smarley2/PSE/Trabalho Final/Imagens layout e circuito/Layout/Layout Top 3d.png

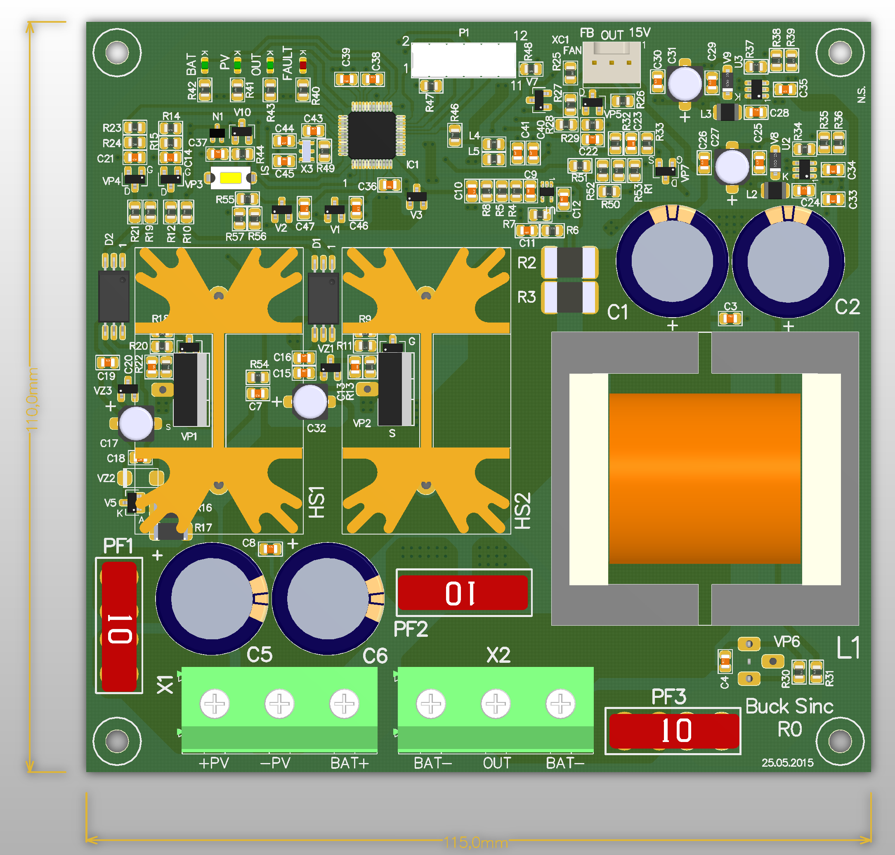
Trabalho Final/Imagens layout e circuito/Layout/Layout Top 3d.png
