smarley2/PSE/Trabalho Final/Apresentação trabalho final.pptx

Entradas: V(t); I(t);

P(t) = V(t) * I(t);

P(t) > P(t-1) ?

Sim

Não

ΔD = ΔD*(-1);

D = D + ΔD;
P(t-1) = P(t);
