smarley2/PSE/Trabalho Final/Imagens ensaio prático/20150711_115641.jpg

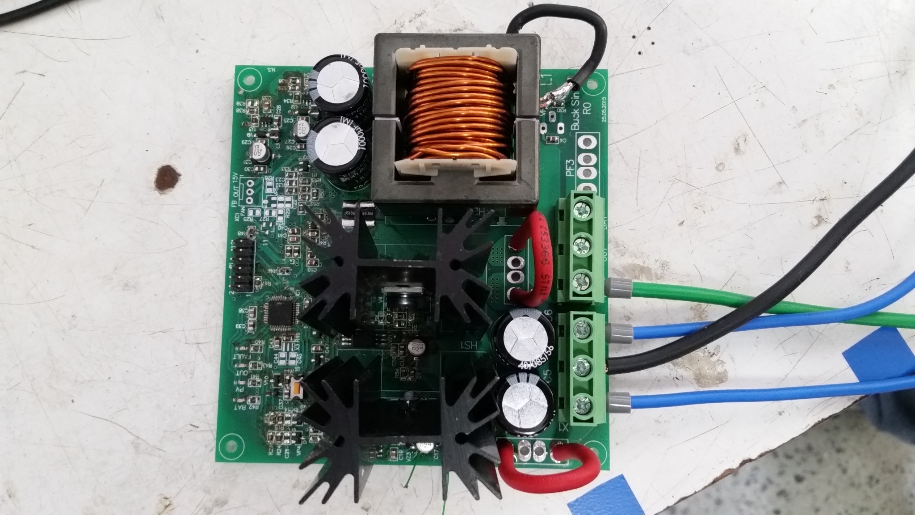
Trabalho Final/Imagens ensaio prático/20150711_115641.jpg
