smarley2/PSE/Trabalho Final/Imagens ensaio prático/20150711_115657.jpg

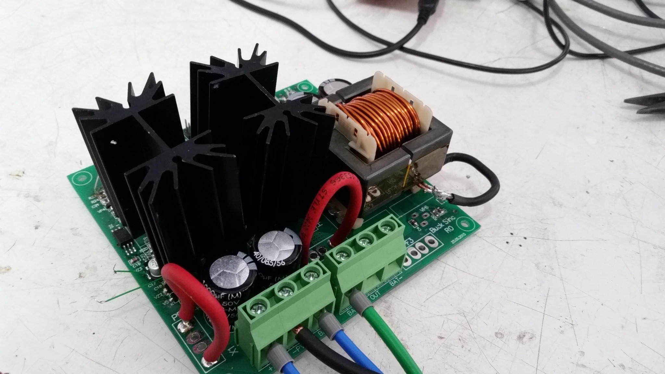
Trabalho Final/Imagens ensaio prático/20150711_115657.jpg
