smarley2/PSE/Trabalho Final/Imagens ensaio prático/20150711_115703.jpg

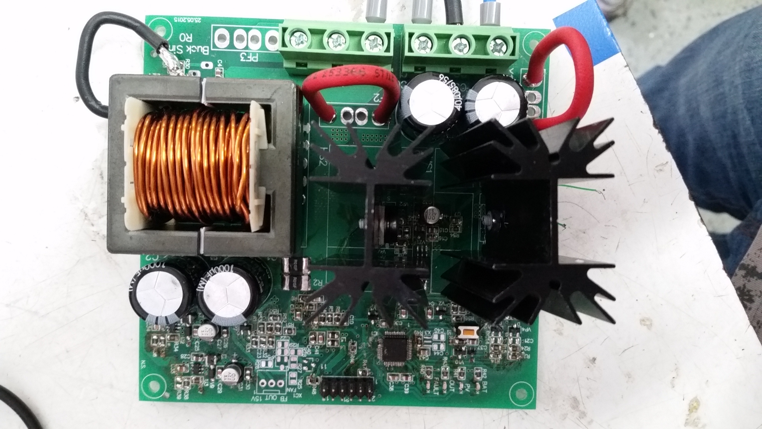
Trabalho Final/Imagens ensaio prático/20150711_115703.jpg
