smarley2/PSE/Trabalho Final/Imagens ensaio prático/20150711_115708.jpg

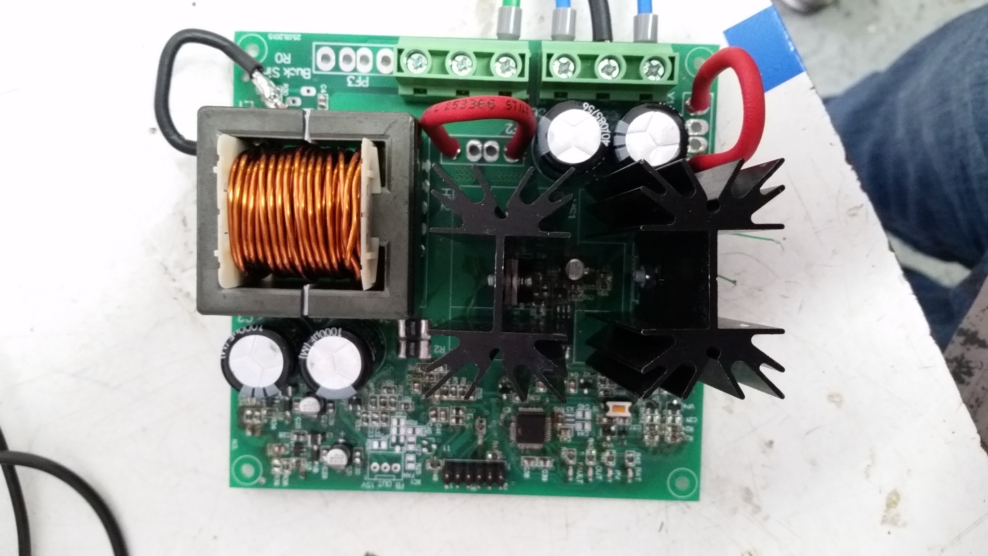
Trabalho Final/Imagens ensaio prático/20150711_115708.jpg
