smarley2/PSE/Trabalho Final/Imagens layout e circuito/Creepage UL840.png

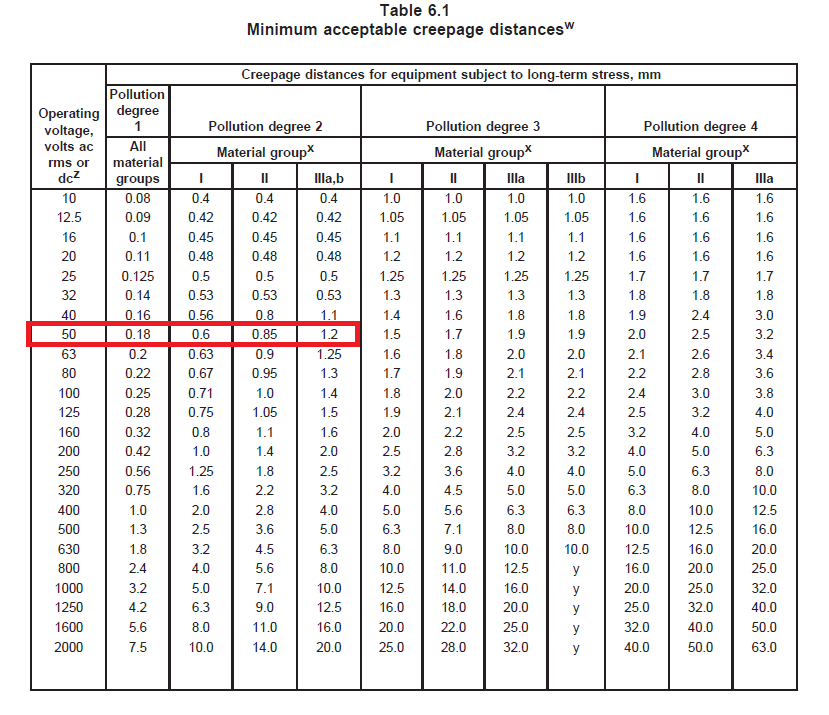
Trabalho Final/Imagens layout e circuito/Creepage UL840.png
