smarley2/PSE/Trabalho Final/Imagens layout e circuito/Layout Reports.png

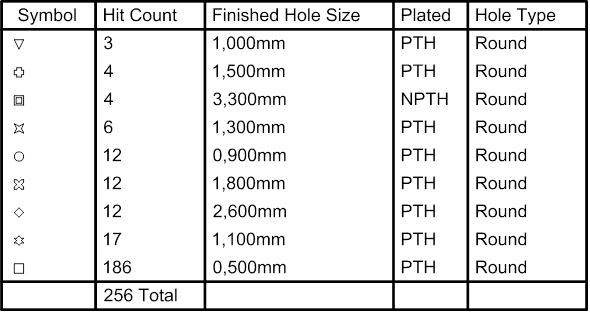
Trabalho Final/Imagens layout e circuito/Layout Reports.png
