smarley2/PSE/Trabalho Final/Imagens layout e circuito/Layout/IPC2221_chart 6-1 Conductor Spacing.png

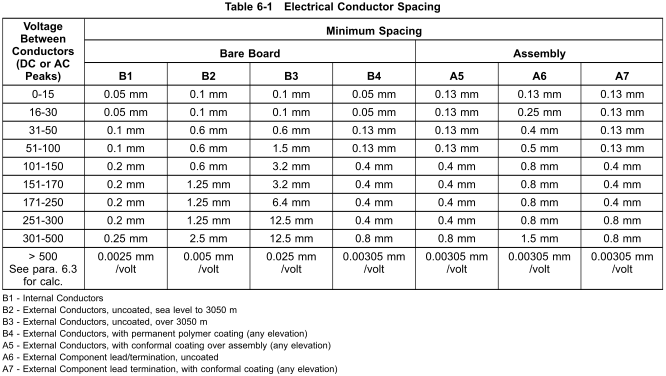
Trabalho Final/Imagens layout e circuito/Layout/IPC2221_chart 6-1 Conductor Spacing.png
