smarley2/PSE/Trabalho Final/Imagens layout e circuito/Layout/Layout 3d_Power.png

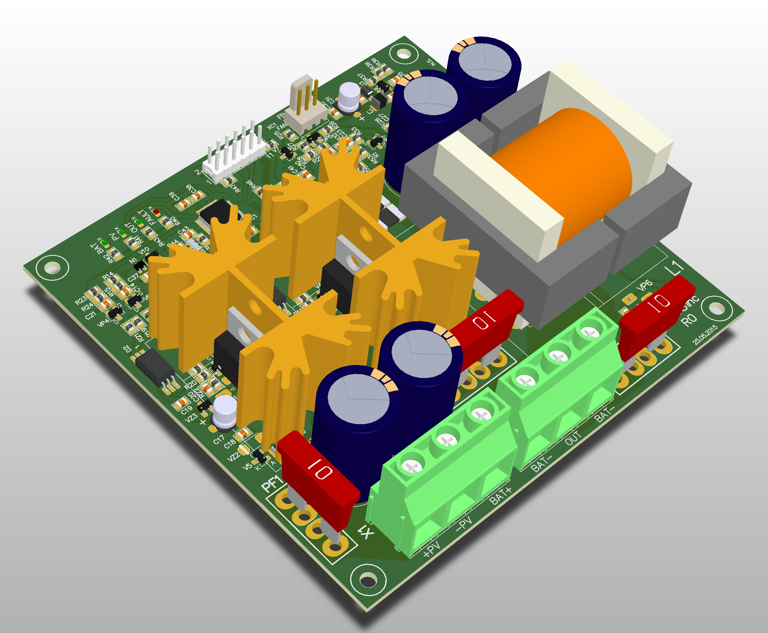
Trabalho Final/Imagens layout e circuito/Layout/Layout 3d_Power.png
