smarley2/PSE/Trabalho Final/Imagens layout e circuito/Layout/Layout Bottom 3d.png

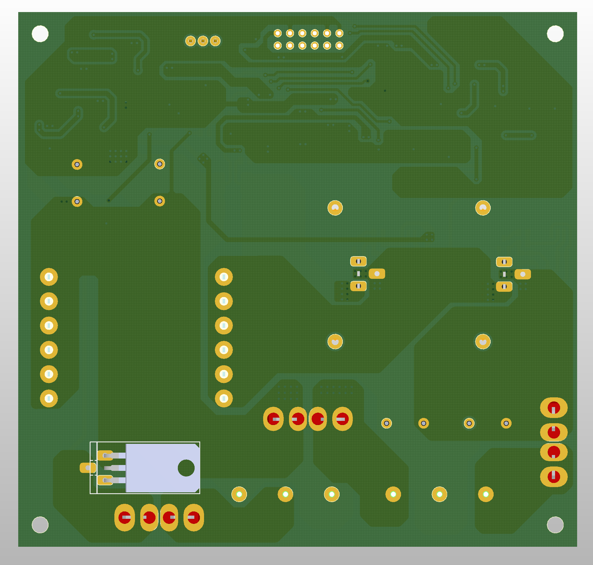
Trabalho Final/Imagens layout e circuito/Layout/Layout Bottom 3d.png
