smarley2/PSE/Trabalho Final/Imagens layout e circuito/Min Creepage UL840.png

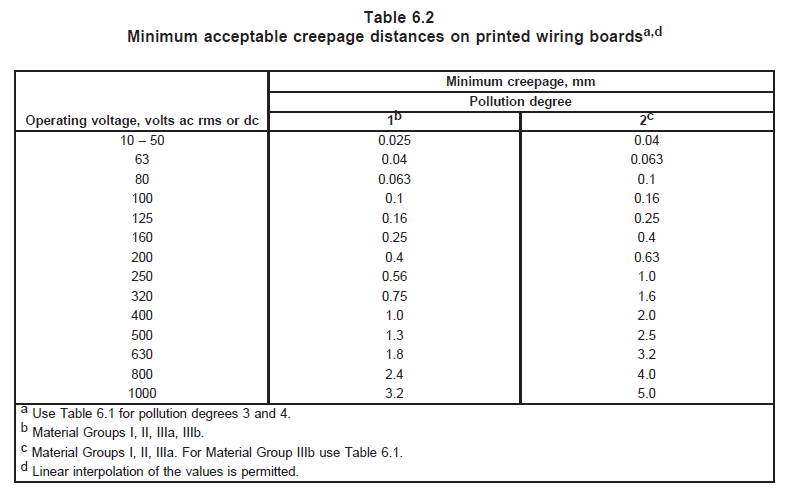
Trabalho Final/Imagens layout e circuito/Min Creepage UL840.png
