smarley2/PSE/Trabalho Final/Imagens layout e circuito/Min Rec Pk Voltage UL840.png

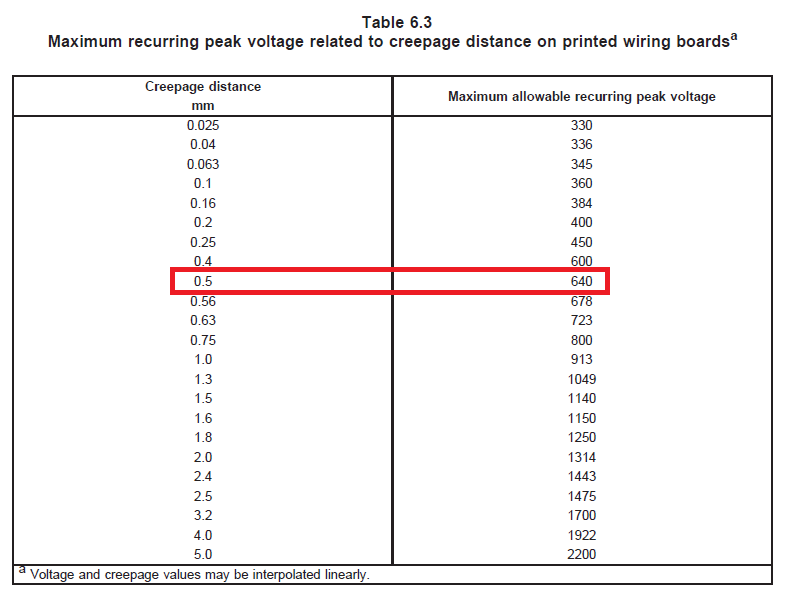
Trabalho Final/Imagens layout e circuito/Min Rec Pk Voltage UL840.png
