smarley2/PSE/Trabalho Final/Imagens layout e circuito/PSIM Power Sim.png

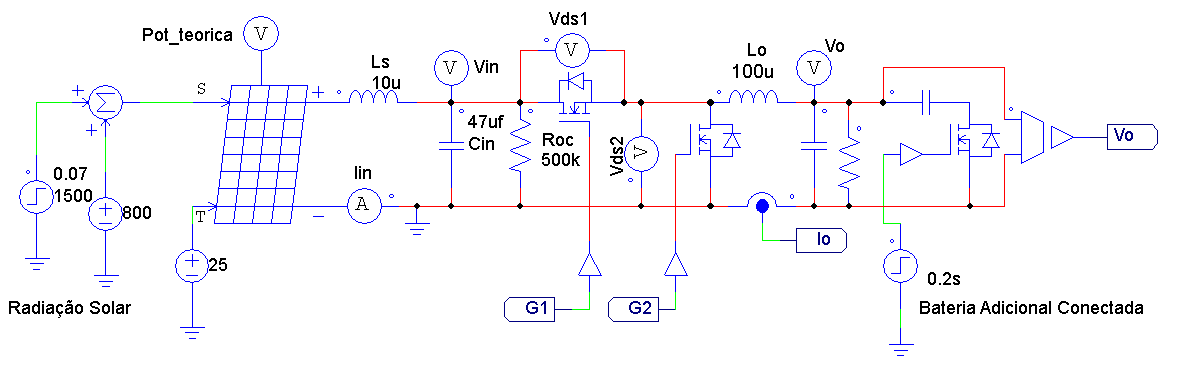
Trabalho Final/Imagens layout e circuito/PSIM Power Sim.png
