smarley2/PSE/Trabalho Final/Imagens layout e circuito/Sch/Aux SMPS-3V3.png

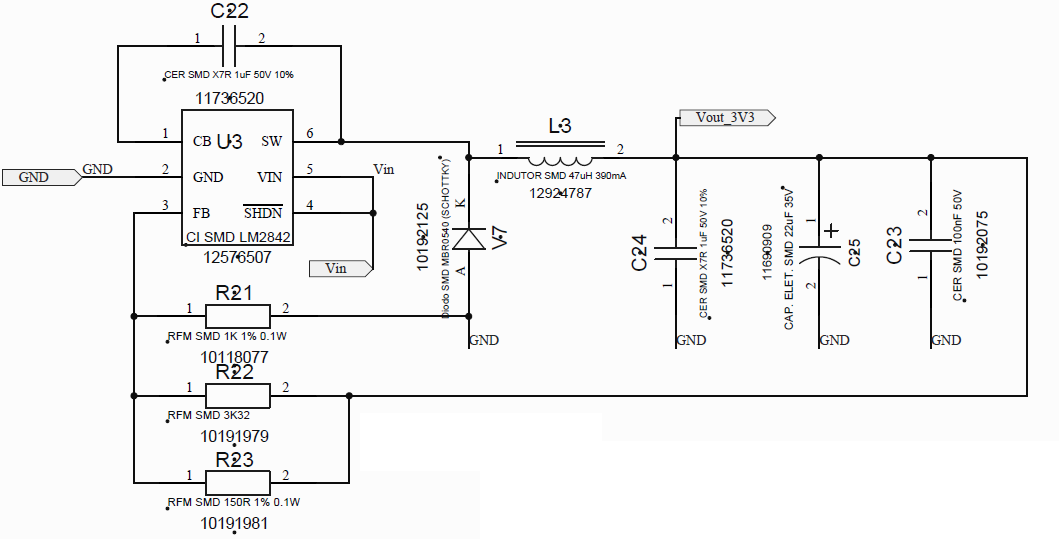
Trabalho Final/Imagens layout e circuito/Sch/Aux SMPS-3V3.png
