smarley2/PSE/Trabalho Final/Imagens layout e circuito/Sch/GD SW.png

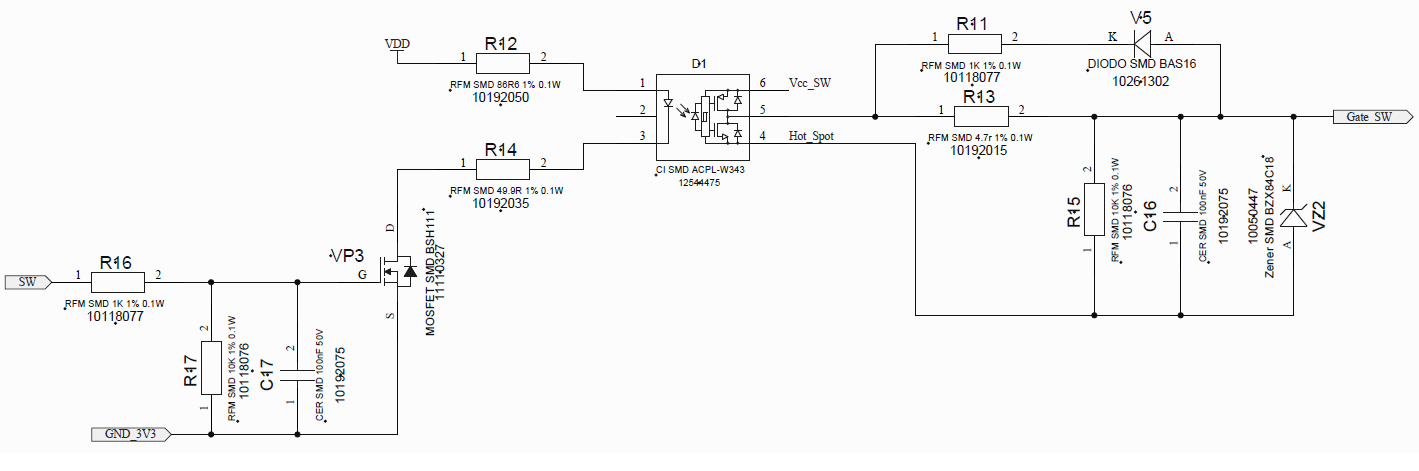
Trabalho Final/Imagens layout e circuito/Sch/GD SW.png
