smarley2/PSE/(list of files, cad)

Other CAD files:
WorkSpace/Example_F2802xAdcSoc/Flash/Example_2802xAdcSoc.obj
WorkSpace/Example_F2802xAdcSoc/RAM/Example_2802xAdcSoc.obj
