smarley2/PSE/(list of files, drawings)

Other design files:
Schematic/Buck_converter.PrjPcb
Schematic/Buck_converter.SchDoc
Schematic/Buck_converter.SCHLIB
Schematic/Conv_buck_R0.PcbDoc
Schematic/Conv_buck_R0.PcbLib
Schematic/Conv_buck_R1.PcbDoc
Schematic/Conv_buck_R1_DTR.PcbDoc
Schematic/Converter.SchDoc
Schematic/Current_measure.SchDoc
Schematic/Driver_rect.SchDoc
Schematic/Driver_SW.SchDoc
Schematic/FAN.SchDoc
Schematic/Output.SchDoc
Schematic/PCB1.PcbDoc
Schematic/Planar design/Planar design.PcbDoc
Schematic/SMPS.SchDoc
Schematic/uC.SchDoc
Schematic/Voltage_measure.SchDoc
