smarley2/PSE/(commit log)

2015-05-15 Adicionado datasheet dos mosfets e diodos adquiridos para montar o conversor.
2015-05-15 Adicionado arquivo de simulação do PSIM.
2015-05-16 Adicionado arquivos para programação.
2015-05-16 Adicionado arquivos do código.
    [Example_2802xAdcSoc.obj]
2015-05-17 Adicionado projeto com esquema.
    [Buck_converter.PrjPcb, Buck_converter.SchDoc, Converter.SchDoc, Current_measure.SchDoc, Driver.SchDoc, Driver_rect.SchDoc, SMPS.SchDoc, Voltage_measure.SchDoc]
2015-05-17 Modificado fonte do driver do retificador para aceitar baterias de até 28,8V. Adicionado resistor de gate e pull down no gate da chave retificadora.
    [Buck_converter.SchDoc, Converter.SchDoc, Current_measure.SchDoc, Driver_rect.SchDoc, SMPS.SchDoc, Voltage_measure.SchDoc, uC.SchDoc]
2015-05-17 Retirado fonte com zener do retificador síncrono e acrescentado um buck.
    [Buck_converter.PrjPcb, Buck_converter.SchDoc, Converter.SchDoc, Current_measure.SchDoc, Driver_rect.SchDoc, SMPS.SchDoc, Voltage_measure.SchDoc, uC.SchDoc]
2015-05-17 Implementado atualização dos PWM's (chave principal, retificador síncrono e SOC). Rampa para rastreamento da máxima potência. Delay na função aguarda();
    [Driver.SchDoc, Driver_SW.SchDoc, Example_2802xAdcSoc.obj, Output.SchDoc]
2015-05-18 adicionado arquivos de simulação do Psim 9
    [parametros_aula4.txt]
2015-05-18 Incluído datasheet tms320f28027_PT.pdf e do gate driver IR2304
2015-05-18 Adicionado item TMS320F28027
    [uC.SchDoc]
2015-05-18 Adicionado circuito da fonte chaveada. Modificado diodo zener do Driver_SW.
    [Driver_SW.SchDoc, SMPS.SchDoc]
2015-05-18 Modificado resistor do zener.
    [Driver_SW.SchDoc]
2015-05-18 Adicionado PCB no projeto, carregados compoenentes. Esquemáticos modificados apenas annotation.
    [Buck_converter.PrjPcb, Conv_buck_R0.PcbDoc, Driver_SW.SchDoc, Driver_rect.SchDoc, Output.SchDoc, SMPS.SchDoc, uC.SchDoc]
2015-05-18 Adicionado resistor em paralelo para regular R1 na tensão de saída dos conversores buck da SMPS.
    [SMPS.SchDoc]
2015-05-18 Adicionado capacitores na entrada, modificado capacitor de saída.
    [Converter.SchDoc, Driver_SW.SchDoc, SMPS.SchDoc]
2015-05-18 Atutalizado designator.
    [Buck_converter.PrjPcb, Buck_converter.SchDoc, Converter.SchDoc, Current_measure.SchDoc, Driver_SW.SchDoc, Driver_rect.SchDoc, Output.SchDoc, SMPS.SchDoc]
2015-05-18 Carregados componentes no PCB devido a revisão no esquemático.
    [Conv_buck_R0.PcbDoc]
2015-05-18 Tabela o fluxo magnético para correntes diferentes e o mesmo projeto e indutância, núcleo e espiras.
2015-05-19 Adicionado arquivo do PSIM versão 9.0
    [MPPT_Buck 90.sch]
2015-05-19 Posicionamento de alguns compnentes: incluido modelo simples com dimensional do indutor e dissipador
    [Conv_buck_R0.PcbDoc]
2015-05-19 Add local library
    [Buck_converter.PrjPcb]
2015-05-19 Created local library
    [Conv_buck_R0.PcbLib]
2015-05-20 Modificado código fonte do projeto. Frequência ajustada em 60kHz. Rotinas de rampa e rastreamento implementadas.
    [Example_2802xAdcSoc.obj]
2015-05-20 Adicionado circuito uC. Redefinidos footprints para lib local. Importado modelo para dissipador, criado modelo simples para indutor.
    [Buck_converter.PrjPcb, Conv_buck_R0.PcbDoc, Conv_buck_R0.PcbLib, Converter.SchDoc, Current_measure.SchDoc, Driver_SW.SchDoc, Driver_rect.SchDoc, Output.SchDoc]
2015-05-20 Revisada célula do indutor. Alterado referência do sensor de tensão PV de -PV para -Bat
    [Buck_converter.PrjPcb, Conv_buck_R0.PcbDoc, Conv_buck_R0.PcbLib, Converter.SchDoc]
2015-05-22 Modificado esquema. Adicionado ventilador. Modificado transistor da saída. Adicionado capacitores maiores para entrada e saída.
    [Buck_converter.PrjPcb, Buck_converter.SchDoc, Converter.SchDoc, Current_measure.SchDoc, Driver_SW.SchDoc, Driver_rect.SchDoc, Output.SchDoc, SMPS.SchDoc]
2015-05-22 Atualizado esquema.
    [Buck_converter.PrjPcb, Buck_converter.SchDoc, Converter.SchDoc, Current_measure.SchDoc, Driver_SW.SchDoc, Driver_rect.SchDoc, Output.SchDoc, SMPS.SchDoc]
2015-05-22 Adicionado circuito do ventilador
    [FAN.SchDoc]
2015-05-22 Adicionado PCB com alguns componentes.
    [Buck_converter.PrjPcb, Driver_rect.SchDoc, FAN.SchDoc, PCB1.PcbDoc]
2015-05-23 Geradas bibliotecas locais Carregados componentes no PCB e inicado o posicionamento e possibilidade de roteamento do circuito
    [Buck_converter.PrjPcb, Buck_converter.SCHLIB, Buck_converter.SchDoc, Conv_buck_R0.PcbDoc, Conv_buck_R0.PcbLib, Conv_buck_R1.PcbDoc, Converter.SchDoc, Current_measure.SchDoc]
2015-05-23 Roteamento layout e inclusão de modelos em alguns componentes
    [Buck_converter.PrjPcb, Conv_buck_R0.PcbLib, Conv_buck_R1.PcbDoc, Converter.SchDoc, Driver_rect.SchDoc, SMPS.SchDoc, uC.SchDoc]
2015-05-24 Layout parcial. Algumas alterações de esquema de acordo com avaliação do layout. - Medição de corrente alimentada com VDDA, assim como diodos de grampeamento das entradas analógicas. - Referecia de t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
    [Buck_converter.PrjPcb, Buck_converter.SchDoc, Conv_buck_R0.PcbLib, Conv_buck_R1.PcbDoc, Converter.SchDoc, Driver_rect.SchDoc, SMPS.SchDoc, uC.SchDoc]
2015-05-24 Roteamento finalizado. Alterado conexão de 3V3 para VDD nos circuitos relacionados aos IOs: Driver_SW.SchDoc, Driver_rect.SchDoc, Buck_converter.SchDoc(sheet FAN) Alterado função dos pinos PWM:
    PWM2A - Int (interrupção do AD)
    PWM2B - SW
    PWM3A - Rect
    PWM1A - FAN (pino 29)
    PWM1B - Out (pino 28)
    [Buck_converter.PrjPcb, Buck_converter.SchDoc, Conv_buck_R0.PcbLib, Conv_buck_R1.PcbDoc, Driver_SW.SchDoc, Driver_rect.SchDoc, uC.SchDoc]
2015-05-25 Removido capacitor extra(haviam 2 em paralelo) do reset, pois circuito está próximo do pino uC. Com a remoção foi alterado roteamento dos sinais da serial possibilitando melhoria no plano DGND Adcici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
    [Buck_converter.PrjPcb, Conv_buck_R1.PcbDoc, uC.SchDoc]
2015-05-25 Gerados arquivos geber para fabricação de protótipo. Adicionado modelo 3d do header 2x6 (JTAG)
    [Buck_converter.PrjPcb, Conv_buck_R0.PcbLib, Conv_buck_R1.PcbDoc]
2015-05-26 Ref para Apresentação PSE
2015-05-28 Atualizado apresentação. adicionado programa para simular a linha de transmissão.
2015-05-28 Finalizadas a apresentação para aula 28/05
2015-06-03 Adicionado AN comentando efeito "shoot through" devido ao dv/dt do mosfet M1 sobre o M2 (retificador)
2015-06-22 Modificado comments dos componentes e montagem na variant.
    [Driver_SW.SchDoc]
2015-06-23 Criado PCBDOC da distribução para montagem PCI.
    [Conv_buck_R1_DTR.PcbDoc]
2015-06-29 Application note about boostrap circuit desing
2015-07-05 Adicionado trabalho final.
    [Example_2802xAdcSoc.obj]
2015-07-05 Criada simulação para gerar imagens para relatório. Alimentação em 24VCC
2015-07-06 Incluidos prints do circuito e layout do conversor
2015-07-06 Alterado simulação para painel 36Vcc
2015-07-06 Realizado annotate nas folhas de Sch e adicionado template com nome do Projeto
    [Buck_converter.PrjPcb, Buck_converter.SchDoc, Converter.SchDoc, Current_measure.SchDoc, Driver_SW.SchDoc, Driver_rect.SchDoc, FAN.SchDoc, Output.SchDoc]
2015-07-06 Simulação para circuito de bootstrap E=29V
    [parametros_aula4.txt]
2015-07-08 Incluido parte projeto de layout
2015-07-09 Gerado config para print SCH, PCB e BOM
    [Buck_converter.PrjPcb, Buck_converter.SchDoc, Conv_buck_R1.PcbDoc, Converter.SchDoc, Current_measure.SchDoc, Driver_SW.SchDoc, Driver_rect.SchDoc, FAN.SchDoc]
2015-07-13 Simulação para transformador planar E14 e E18
    [Planar design.PcbDoc]
